SteveMayze/Central-Command/doc/CC-Back-V01.png

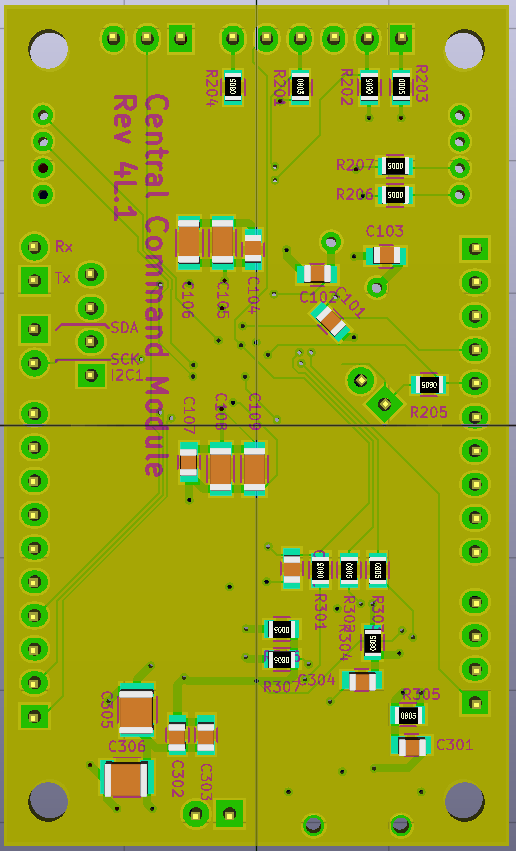
doc/CC-Back-V01.png
