SteveMayze/Central-Command/doc/CC-Back-V02.png

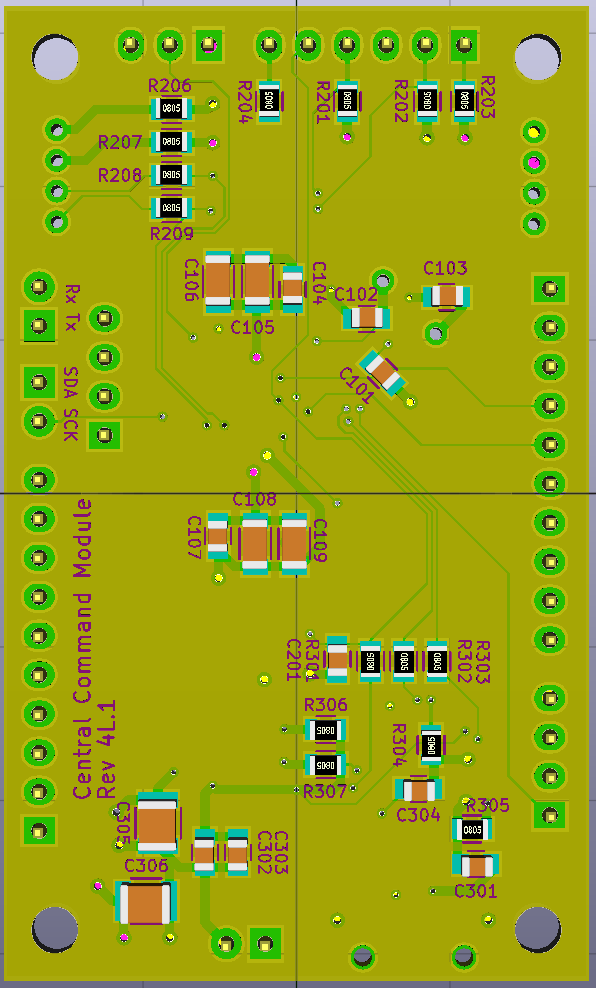
doc/CC-Back-V02.png
