SteveMayze/Central-Command/doc/CC-Front-V01.png

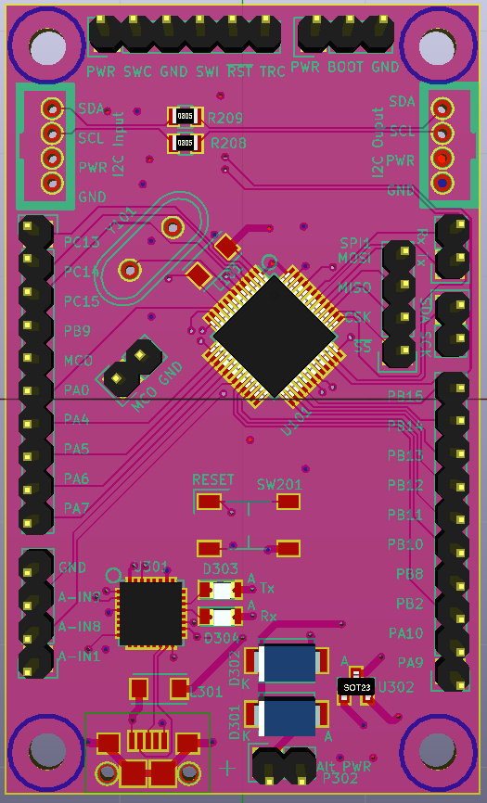
doc/CC-Front-V01.png
