SteveMayze/Central-Command/doc/CC-Front-V02.png

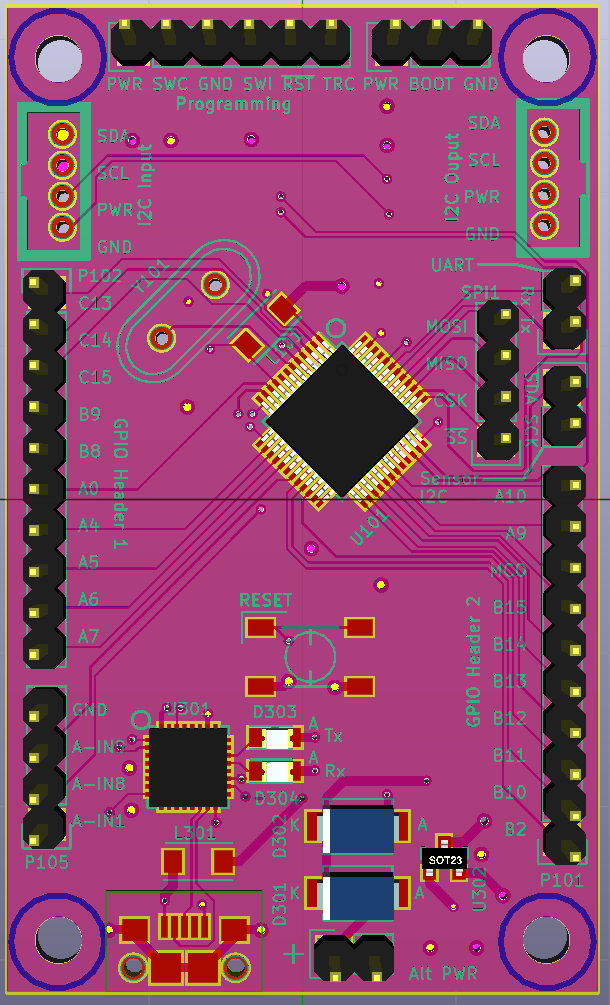
doc/CC-Front-V02.png
