SteveMayze/Central-Command/doc/CC-Layout-V01.png

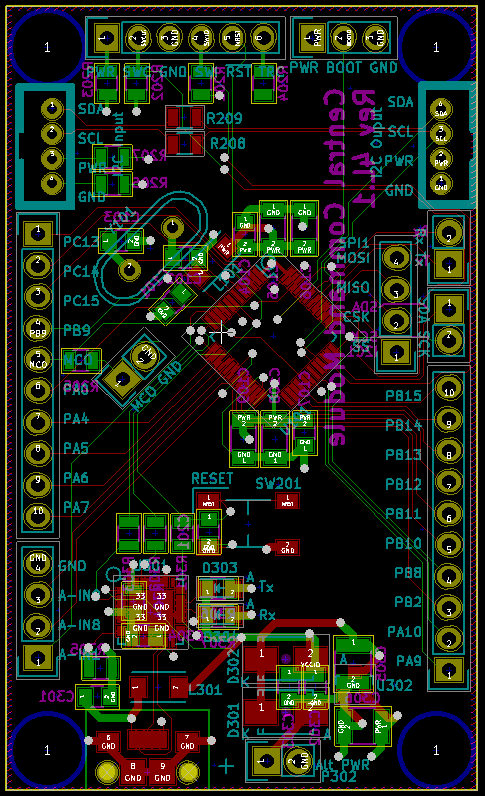
doc/CC-Layout-V01.png
