SteveMayze/Central-Command/doc/CC-Layout-V02.png

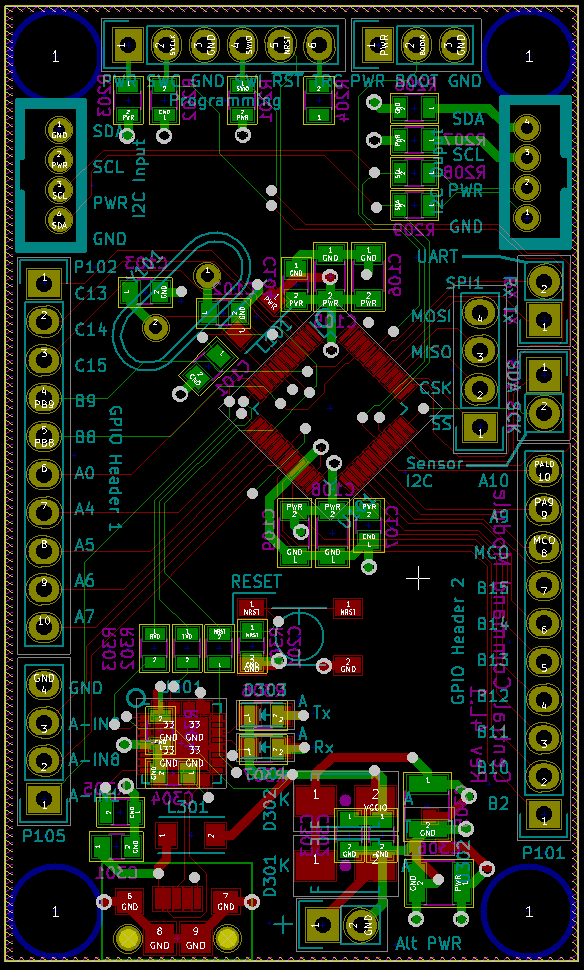
doc/CC-Layout-V02.png
