SteveMayze/Central-Command/doc/draftLayout-151210.png

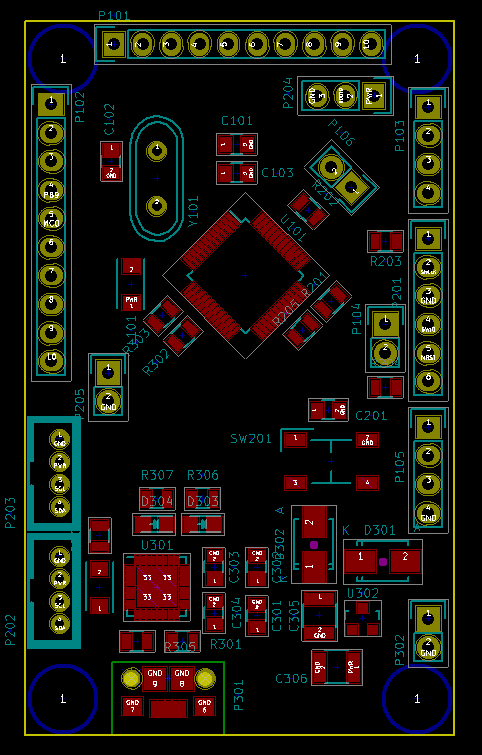
doc/draftLayout-151210.png
