SteveMayze/Central-Command/doc/OSHPark-Back.png

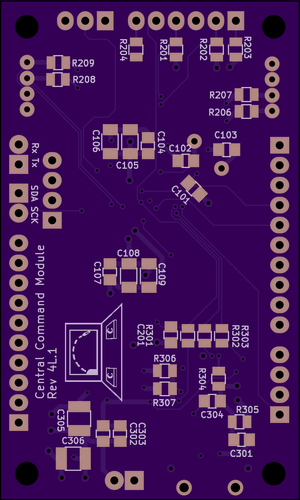
doc/OSHPark-Back.png
