SteveMayze/Central-Command/doc/OSHPark-Front.png

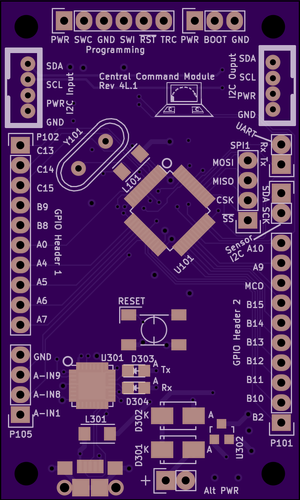
doc/OSHPark-Front.png
