SteveMayze/Central-Command/pcb-r1/Central-Command.kicad_pcb

## KiCad design pcb-r1/Central-Command.kicad_pcb (2016-07-05)

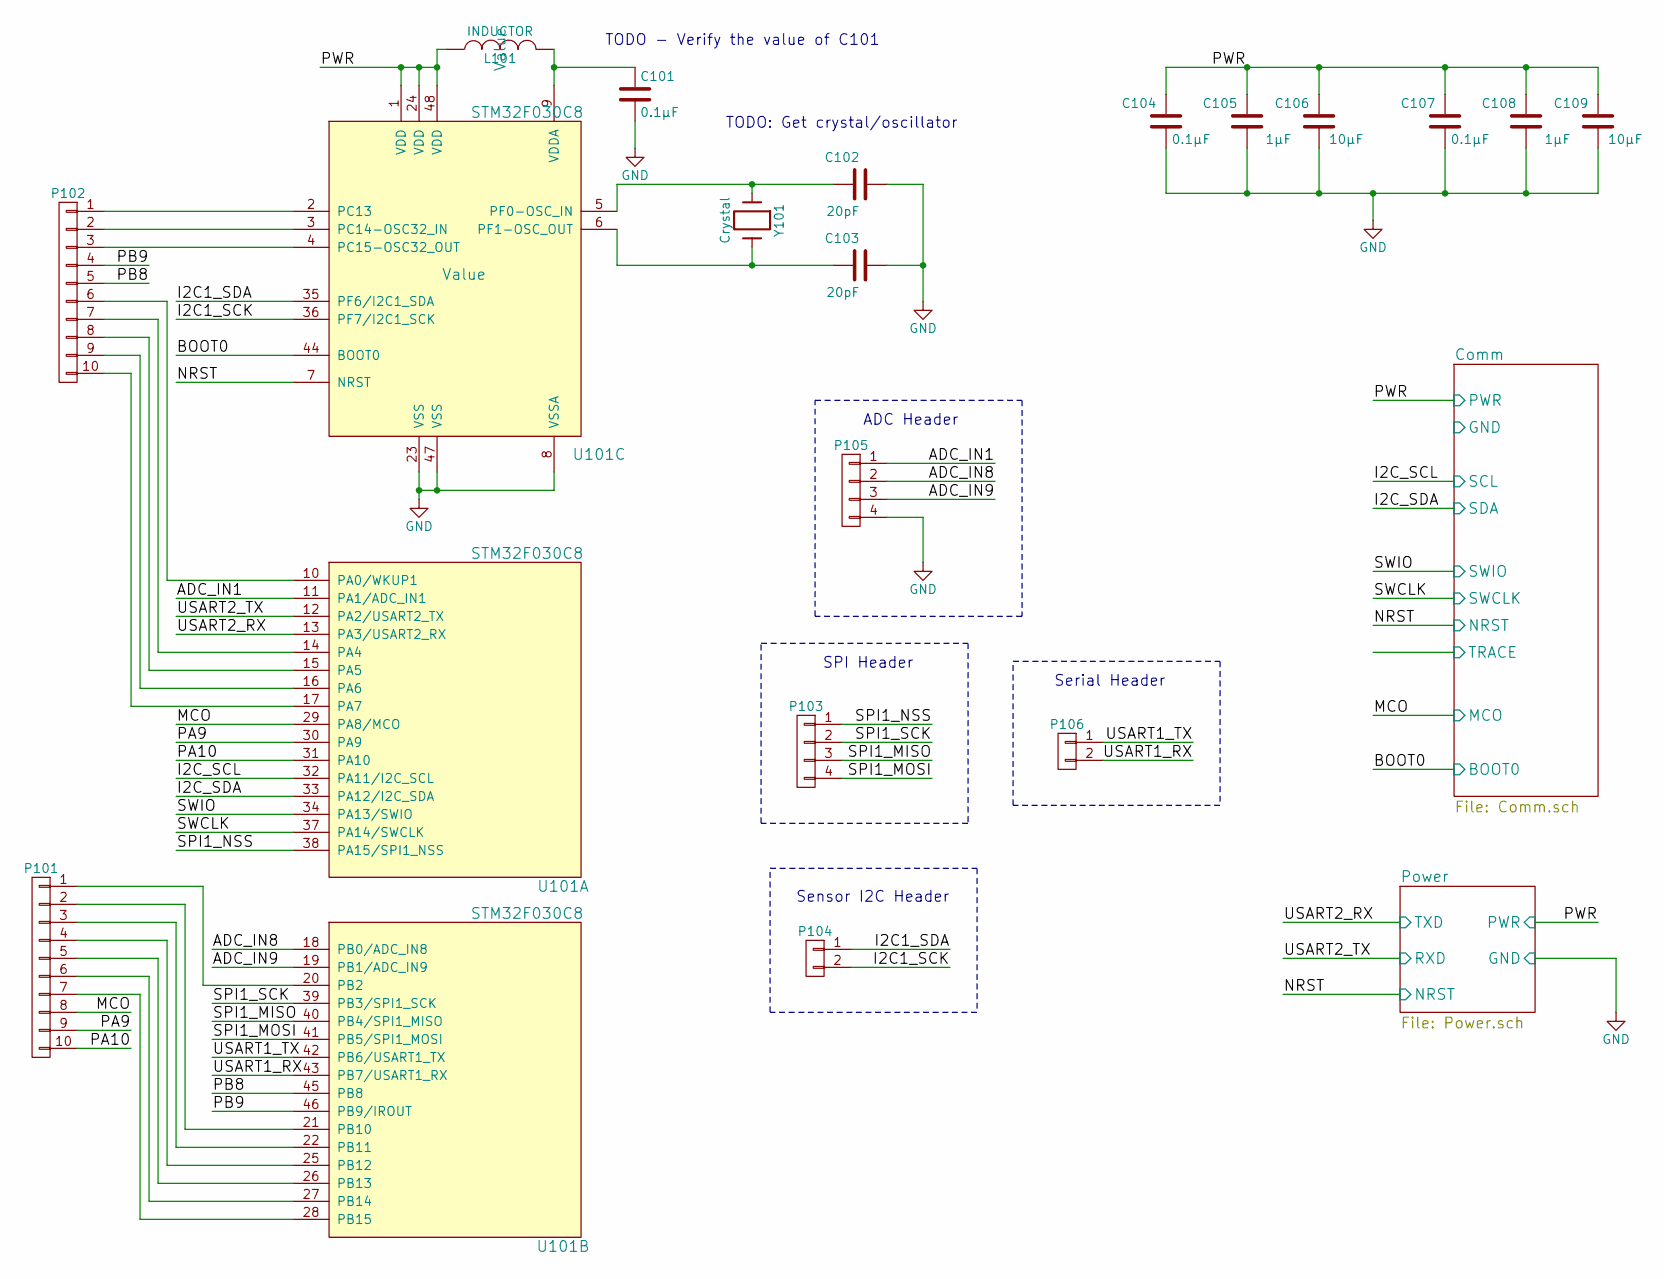
[picture p10: schematic Central-Command.sch]

Parts:
C101, C104, C107: 0.1μF; C_0805; DigiKeyPN 478-1395-1-ND
C102, C103: 20pF; C_0805; DigiKeyPN 1276-1829-1-ND
C105, C108: 1μF; C_1206; DigiKeyPN 311-1951-1-ND
C106, C109: 10μF; C_1206; DigiKeyPN 1276-2865-1-ND
L101: INDUCTOR; Neosid_Inductor_SM1206; MPN LQH31CN100K03L; DigiKeyPN 490-6588-1-ND
P101, P102: CONN_01X10; Pin_Header_Straight_1x10
P103, P105: CONN_01X04; Pin_Header_Straight_1x04
P104, P106: CONN_01X02; Pin_Header_Straight_1x02
U101: STM32F030C8; LQFP-48_7x7mm_Pitch0.5mm
Y101: Crystal; Crystal_HC49-U_Vertical; MPN FOXSLF/080-20; DigiKeyPN 631-1100-ND

Connections:
/ADC_IN1: P105.1, U101.11 (PA1/ADC_IN1)
/ADC_IN8: P105.2, U101.18 (PB0/ADC_IN8)
/ADC_IN9: P105.3, U101.19 (PB1/ADC_IN9)
/Comm/BOOT0: U101.44 (BOOT0); also elsewhere on the board
/Comm/NRST: U101.7 (NRST); also elsewhere on the board
/Comm/PWR: C104.2, C105.2, C106.2, C107.2, C108.2, C109.2, L101.1, U101.1 (VDD), U101.24 (VDD), U101.48 (VDD); also elsewhere on the board
/Comm/SCL: U101.32 (PA11/I2C_SCL); also elsewhere on the board
/Comm/SDA: U101.33 (PA12/I2C_SDA); also elsewhere on the board
/Comm/SWCLK: U101.37 (PA14/SWCLK); also elsewhere on the board
/Comm/SWIO: U101.34 (PA13/SWIO); also elsewhere on the board
/I2C1_SCK: P104.2, U101.36 (PF7/I2C1_SCK)
/I2C1_SDA: P104.1, U101.35 (PF6/I2C1_SDA)
/MCO: P101.8, U101.29 (PA8/MCO)
/PA9: P101.9, U101.30 (PA9)
/PA10: P101.10, U101.31 (PA10)
/PB8: P102.5, U101.45 (PB8)
/PB9: P102.4, U101.46 (PB9/IROUT)
/Power/RXD: U101.12 (PA2/USART2_TX); also elsewhere on the board
/Power/TXD: U101.13 (PA3/USART2_RX); also elsewhere on the board
/SPI1_MISO: P103.3, U101.40 (PB4/SPI1_MISO)
/SPI1_MOSI: P103.4, U101.41 (PB5/SPI1_MOSI)
/SPI1_NSS: P103.1, U101.38 (PA15/SPI1_NSS)
/SPI1_SCK: P103.2, U101.39 (PB3/SPI1_SCK)
/USART1_RX: P106.2, U101.43 (PB7/USART1_RX)
/USART1_TX: P106.1, U101.42 (PB6/USART1_TX)
GND: C101.2, C102.2, C103.2, C104.1, C105.1, C106.1, C107.1, C108.1, C109.1, P105.4, U101.8 (VSSA), U101.23 (VSS), U101.47 (VSS); also elsewhere on the board
unnamed: C101.1, L101.2, U101.9 (VDDA)
unnamed: C102.1, U101.5 (PF0-OSC_IN), Y101.1
unnamed: C103.1, U101.6 (PF1-OSC_OUT), Y101.2
unnamed: P101.1, U101.20 (PB2)
unnamed: P101.2, U101.21 (PB10)
unnamed: P101.3, U101.22 (PB11)
unnamed: P101.4, U101.25 (PB12)
unnamed: P101.5, U101.26 (PB13)
unnamed: P101.6, U101.27 (PB14)
unnamed: P101.7, U101.28 (PB15)
unnamed: P102.1, U101.2 (PC13)
unnamed: P102.2, U101.3 (PC14-OSC32_IN)
unnamed: P102.3, U101.4 (PC15-OSC32_OUT)
unnamed: P102.6, U101.10 (PA0/WKUP1)
unnamed: P102.7, U101.14 (PA4)
unnamed: P102.8, U101.15 (PA5)
unnamed: P102.9, U101.16 (PA6)
unnamed: P102.10, U101.17 (PA7)

Notes on the sheet:
TODO: Get crystal/oscillator
ADC Header
SPI Header
Serial Header
Sensor I2C Header
TODO - Verify the value of C101

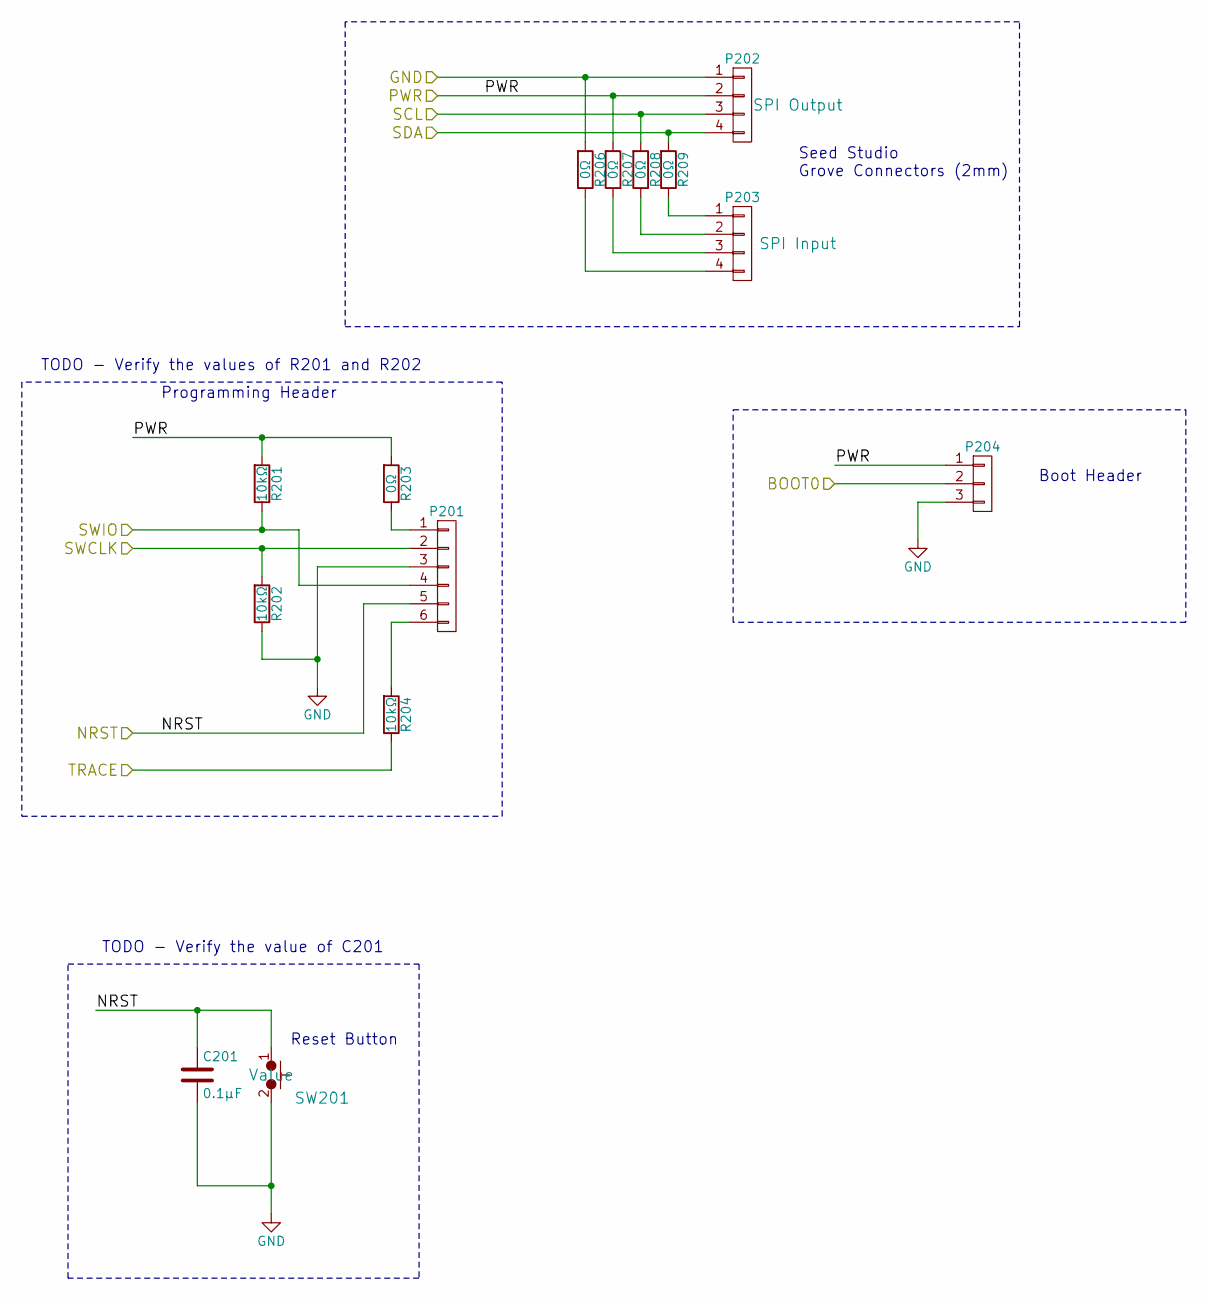
[picture p11: schematic Comm.sch]

Parts:
C201: 0.1μF; C_0805; DigiKeyPN 478-1395-1-ND
P201: CONN_01X06; Pin_Header_Straight_1x06; DigiKeyPN 952-2247-ND
P202, P203: CONN_01X04; Grove-2mm; MPN Value
P204: CONN_01X03; Pin_Header_Straight_1x03
R201, R202, R204: 10kΩ; R_0805; DigiKeyPN 311-10.0KCRCT-ND
R203, R206, R207, R208, R209: 0Ω; R_0805
SW201: TL3315NF160Q; PTS525SM15SMTR2LFS; MPN FSM2JSMAA; DigiKeyPN FSM2JSMAA-ND

Connections:
/Comm/BOOT0: P204.2; also elsewhere on the board
/Comm/NRST: C201.1, P201.5, SW201.1; also elsewhere on the board
/Comm/PWR: P202.2, P204.1, R201.2, R203.2, R207.2; also elsewhere on the board
/Comm/SCL: P202.3, R208.2; also elsewhere on the board
/Comm/SDA: P202.4, R209.2; also elsewhere on the board
/Comm/SWCLK: P201.2, R202.2; also elsewhere on the board
/Comm/SWIO: P201.4, R201.1; also elsewhere on the board
/Comm/TRACE: R204.1
GND: C201.2, P201.3, P202.1, P204.3, R202.1, R206.2, SW201.2; also elsewhere on the board
unnamed: P201.1, R203.1
unnamed: P201.6, R204.2
unnamed: P203.1, R209.1
unnamed: P203.2, R208.1
unnamed: P203.3, R207.1
unnamed: P203.4, R206.1

Notes on the sheet:
Reset Button
Programming Header
Seed Studio Grove Connectors (2mm)
Boot Header
TODO - Verify the values of R201 and R202
TODO - Verify the value of C201

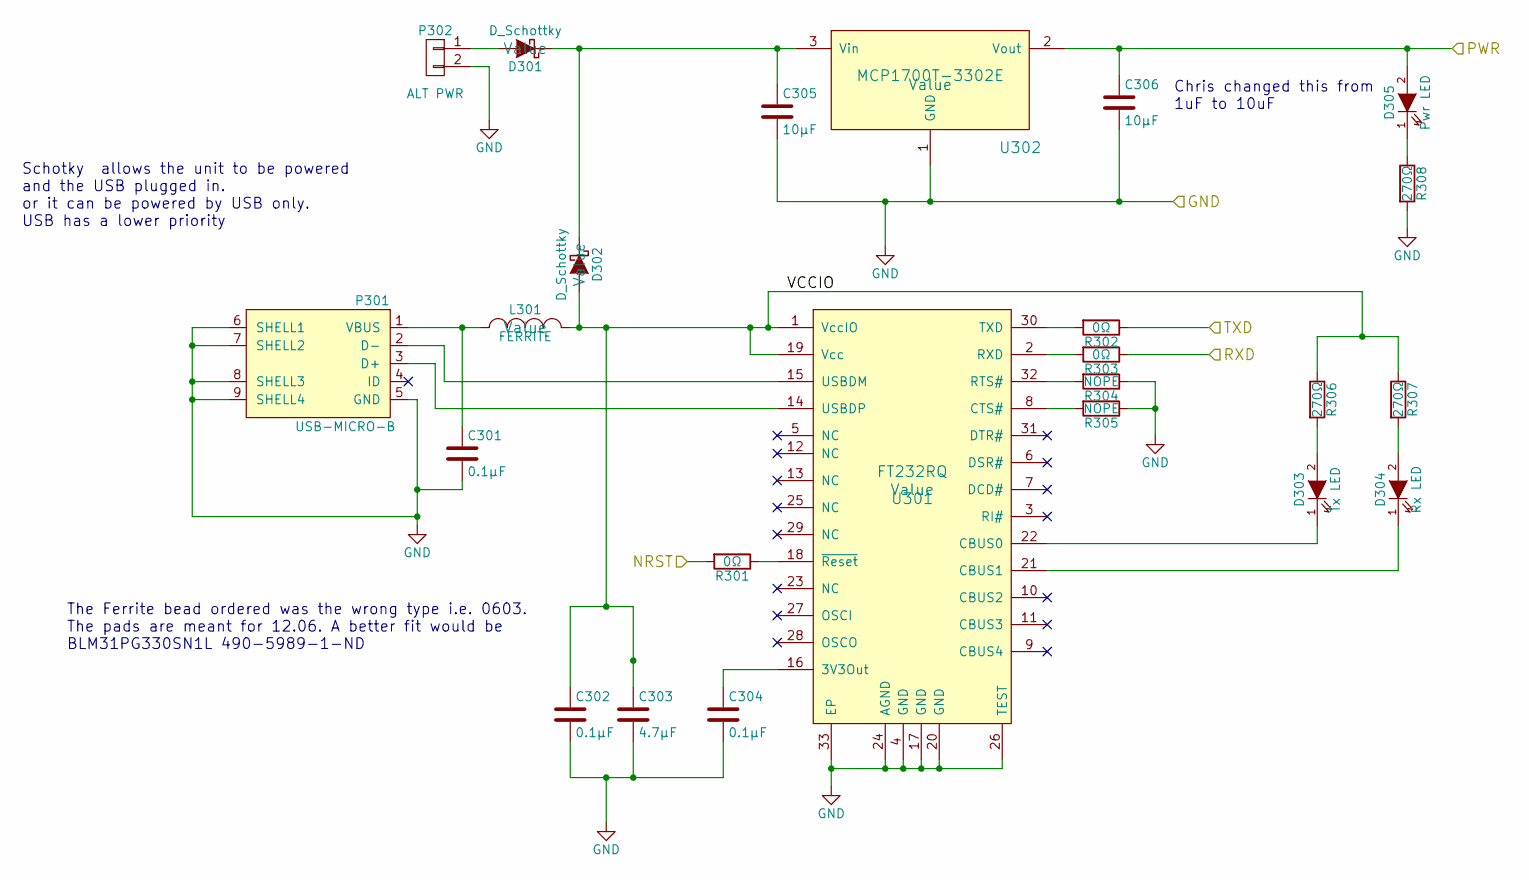
[picture p12: schematic Power.sch]

Parts:
C301: 0.1μF; C_0805
C302, C304: 0.1μF; C_0805; DigiKeyPN 478-1395-1-ND
C303: 4.7μF; C_0805; DigiKeyPN 1276-1856-1-ND
C305: 10μF; C_1210; DigiKeyPN 1276-2865-1-ND
C306: 10μF; C_1210
D301, D302: D_Schottky; SMA_Standard; MPN B130-13-F; DigiKeyPN B130-FDICT-ND
D303: Tx LED; LED-0805
D304: Rx LED; LED-0805
D305: Pwr LED; LED-0805; Voltage Value; DigiKeyPN Value
L301: FERRITE; Neosid_Inductor_SM1206; Voltage Value; MPN BLM31PG330SN1L; DigiKeyPN 490-5989-1-ND
P301: USB-MICRO-B; USB_Micro_B
P302: ALT PWR; Pin_Header_Straight_1x02
R301, R302, R303: 0Ω; R_0805
R304, R305: NOPE; R_0805
R306, R307, R308: 270Ω; R_0805
U301: FT232RQ; QFN-32-1EP_5x5mm_Pitch0.5mm; MPN FT232RQ-REEL; DigiKeyPN 768-1008-1-ND
U302: MCP1700T-3302E; SOT-23; MPN MCP1700T-3302E/TT; DigiKeyPN MCP1700T3302ETTCT-ND

Connections:
/Comm/NRST: R301.2; also elsewhere on the board
/Comm/PWR: C306.1, D305.2 (A), U302.2 (Vout); also elsewhere on the board
/Power/RXD: R303.1; also elsewhere on the board
/Power/TXD: R302.1; also elsewhere on the board
/Power/VCCIO: C302.1, C303.1, D302.2 (A), L301.2, R306.1, R307.1, U301.1 (VccIO), U301.19 (Vcc)
GND: C301.2, C302.2, C303.2, C304.2, C305.2, C306.2, P301.5 (GND), P301.6 (SHELL1), P301.7 (SHELL2), P301.8 (SHELL3), P301.9 (SHELL4), P302.2, R304.1, R305.1, R308.2, U301.4 (GND), U301.17 (GND), U301.20 (GND), U301.24 (AGND), U301.26 (TEST), U301.33 (EP), U302.1 (GND); also elsewhere on the board
unnamed: C301.1, L301.1, P301.1 (VBUS)
unnamed: C304.1, U301.16 (3V3Out)
unnamed: C305.1, D301.1 (K), D302.1 (K), U302.3 (Vin)
unnamed: D301.2 (A), P302.1
unnamed: D303.1 (K), U301.22 (CBUS0)
unnamed: D303.2 (A), R306.2
unnamed: D304.1 (K), U301.21 (CBUS1)
unnamed: D304.2 (A), R307.2
unnamed: D305.1 (K), R308.1
unnamed: P301.2 (D-), U301.15 (USBDM)
unnamed: P301.3 (D+), U301.14 (USBDP)
unnamed: R301.1, U301.18 (~Reset)
unnamed: R302.2, U301.30 (TXD)
unnamed: R303.2, U301.2 (RXD)
unnamed: R304.2, U301.32 (RTS#)
unnamed: R305.2, U301.8 (CTS#)

Notes on the sheet:
Schotky allows the unit to be powered and the USB plugged in. or it can be powered by USB only. USB has a lower priority
Chris changed this from 1uF to 10uF
The Ferrite bead ordered was the wrong type i.e. 0603. The pads are meant for 12.06. A better fit would be BLM31PG330SN1L 490-5989-1-ND

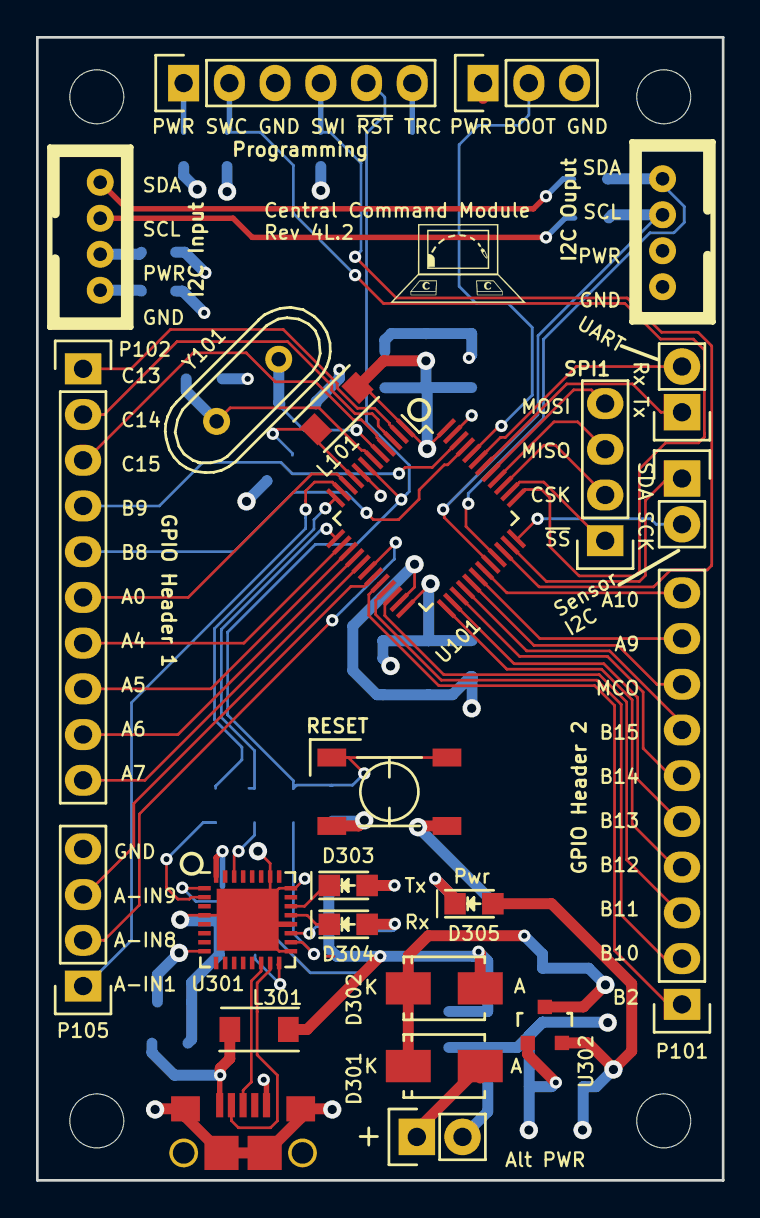
[picture p13: board Central-Command.kicad_pcb from above]

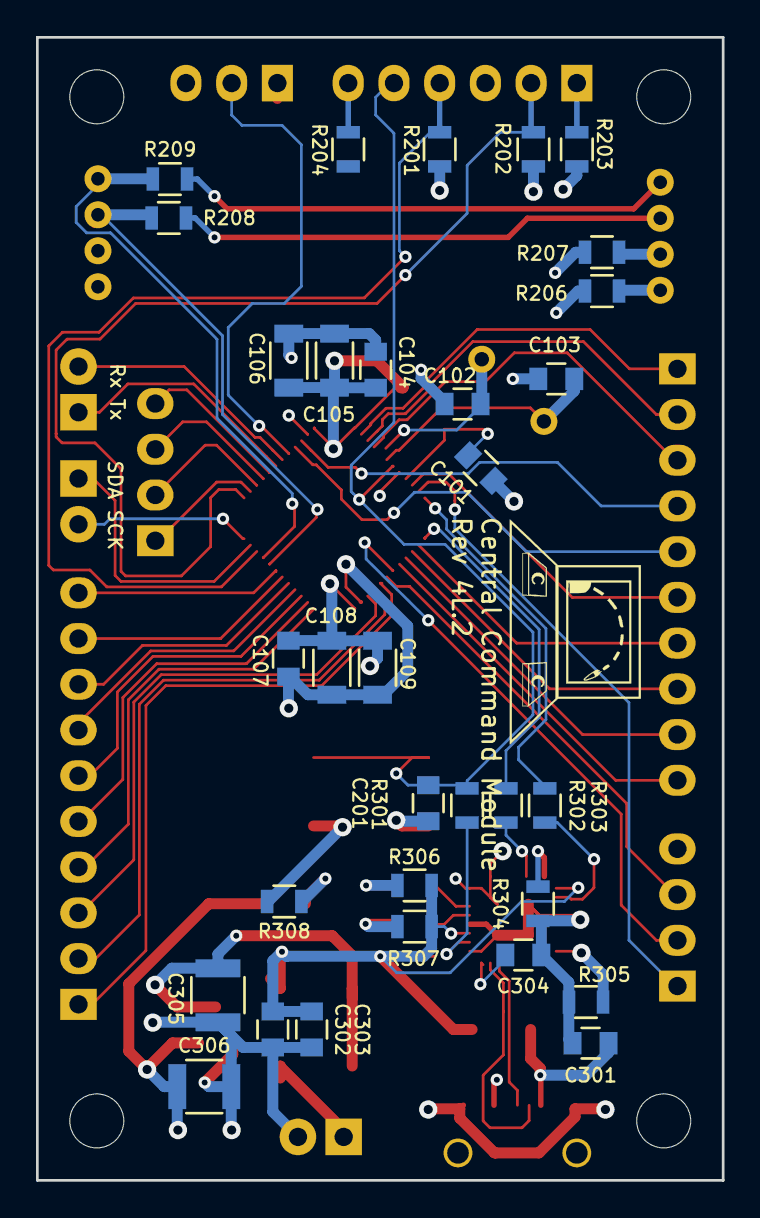
[picture p14: board Central-Command.kicad_pcb from below]

Board: 4 copper layers, 38.1 x 63.5 mm, 56 parts (32 on the bottom side), 67 nets.
