SteveMayze/Central-Command/(commit log)

2015-10-12 Added kicad project
    [Central-Command.kicad_pcb, Central-Command.sch]
2015-10-13 Completed the symbol for the micro
    [Central-Command.sch]
2015-11-02 Updated the Micro symbol as per datasheet markup and started adding some more symols as per CC07-CC11
    [Central-Command.sch]
2015-11-06 Added linear voltage regulator
    [Central-Command.sch]
2015-11-22 Started layout to figure out sizes and features
    [Central-Command.kicad_pcb, Central-Command.sch]
2015-11-24 Updated for CC13 and CC14
    [Central-Command.sch]
2015-11-27 Added power block hierarchical sheet, FT232RQ and Micro-B USB symbols
    [Central-Command.sch, Power.sch]
2015-11-29 Added further enhancements to the power block
    [Power.sch]
2015-12-08 Updated the schematic with the latest from CC17
    [Central-Command.sch, Comm.sch, Power.sch]
2015-12-08 Edited the Central-Command.sch and forced the order of the hierarchical sheets to match the reference schematic annotations. Also annotated
    [Central-Command.sch, Comm.sch, Power.sch]
2015-12-08 Added the Grove2mm connector footprint
2015-12-08 Started the part to footprint association
    [Central-Command.sch, Comm.sch, Power.sch]
2015-12-09 Started preliminary layout of the parts
    [Central-Command.kicad_pcb, Central-Command.sch, Comm.sch, Power.sch]
2015-12-10 New initial layout
    [Central-Command.kicad_pcb, Central-Command.sch, Comm.sch]
2015-12-12 Corrected the symbol and footprint for the reset switch
    [Central-Command.kicad_pcb, Comm.sch]
2015-12-25 Updates to the PCB
    [Central-Command.kicad_pcb]
2015-12-26 Intermediate save of the layout
    [Central-Command.kicad_pcb, Central-Command.sch, Comm.sch, Power.sch]
2015-12-26 Started the basic layout.
    [Central-Command.kicad_pcb]
2015-12-27 Final draft layout. Published to build log as V01
    [Central-Command-B.Cu.gbr, Central-Command-B.Mask.gbr, Central-Command-B.Paste.gbr, Central-Command-B.SilkS.gbr, Central-Command-Edge.Cuts.gbr, Central-Command-F.Cu.gbr, Central-Command-F.Mask.gbr, Central-Command-F.Paste.gbr]
2015-12-28 Completed the layout. Saving before sending off to Fab.
    [Central-Command-B.Cu.gbr, Central-Command-B.Mask.gbr, Central-Command-B.Paste.gbr, Central-Command-B.SilkS.gbr, Central-Command-Edge.Cuts.gbr, Central-Command-F.Cu.gbr, Central-Command-F.Mask.gbr, Central-Command-F.Paste.gbr]
2015-12-31 Realigned the UART and Sensor labels
    [Central-Command.kicad_pcb]
2016-01-04 Generated the final Gerbers for fabrication
    [Central-Command-B.Cu.GBL, Central-Command-B.Mask.GBS, Central-Command-B.Paste.GBP, Central-Command-B.SilkS.GBO, Central-Command-Edge.Cuts.GKO, Central-Command-F.Cu.GTL, Central-Command-F.Mask.GTS, Central-Command-F.Paste.GTP]
2016-01-10 Preparing the BOM
    [Central-Command.csv, Central-Command.sch, Comm.sch]
2016-01-10 Added the MPN for the crystal
    [Central-Command.csv, Central-Command.sch]
2016-02-02 Updated the parts for the BOM
    [Central-Command.sch, Comm.sch, Power.sch]
2016-02-02 Updated the parts with further DigiKeyPN
    [Central-Command.sch, Comm.sch, Power.sch]
2016-02-13 Made the correction to the Tx Rx on the schematic and added a comment regarding the Ferrite Bead
    [Central-Command.sch, Power.sch]
2016-02-13 Corrected the routing of the Tx and Rx
    [Central-Command.kicad_pcb]
2016-05-07 Updated the L301 to a 1206 part rather than 0603
    [Power.sch]
2016-07-05 Completed revised board 4L.2 and submitted to OSH Park
    [Central-Command.kicad_pcb, Power.sch]
